Oyion2003/IoT-Based-Parliamentary-Voting-System/Version_2(ongoing)/Testing/FingerPrint_Sensor_Test/WhatsApp Image 2026-10-29 at 8.06.59 PM (2).jpeg

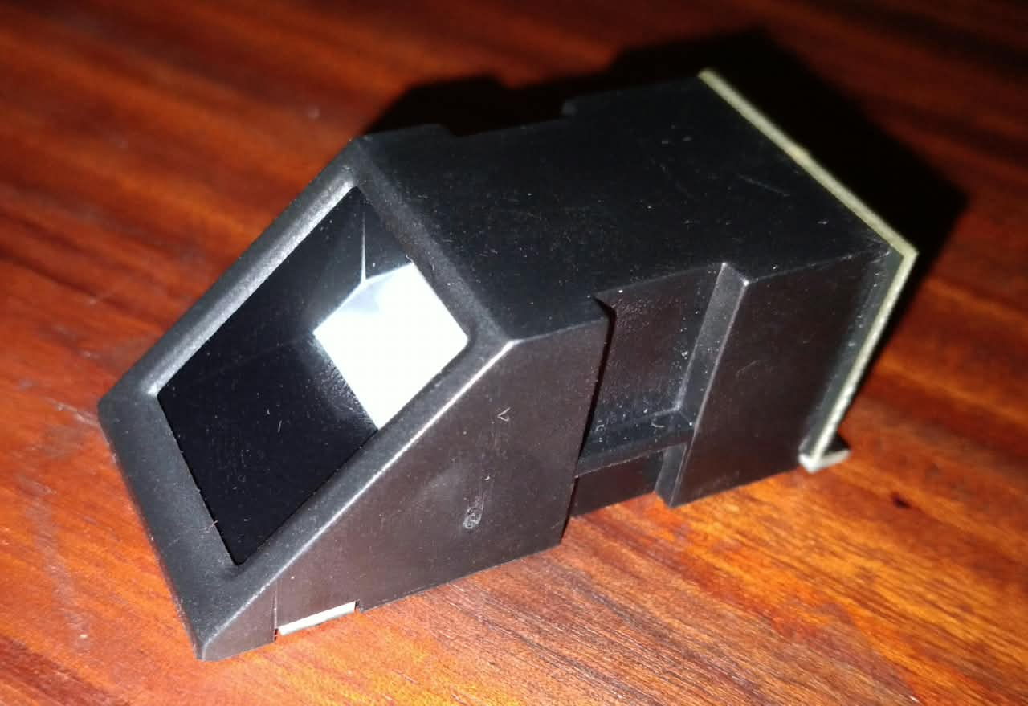
Version_2(ongoing)/Testing/FingerPrint_Sensor_Test/WhatsApp Image 2026-10-29 at 8.06.59 PM (2).jpeg
