Oyion2003/IoT-Based-Parliamentary-Voting-System/(commit log)

2026-10-21 Update the development plan for a cleaner, more structured, visual project roadmap and execution flow.
2026-10-29 New device testing with ESP32
2026-10-29 Sensor Images
